Dominikmloy/fraction-collector/Collector_step/Führung lang v1.step

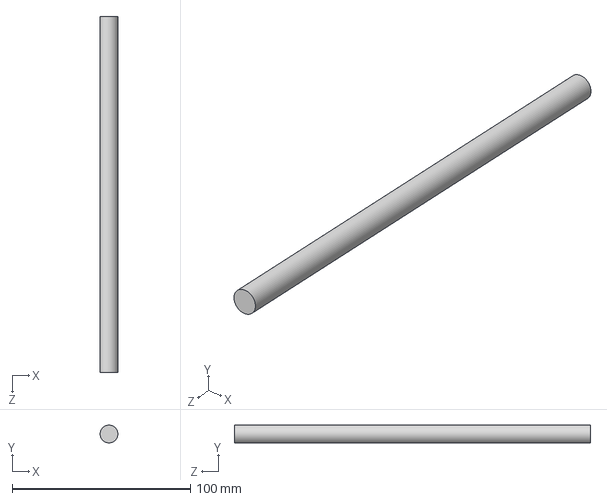
[picture p1: CAD file, 2020-12-05]
Collector_step/Führung lang v1.step
9.99 x 10.00 x 200.0 mm
