Dominikmloy/fraction-collector/Collector_step/Zahnscheibe T5 14-2  v1.step

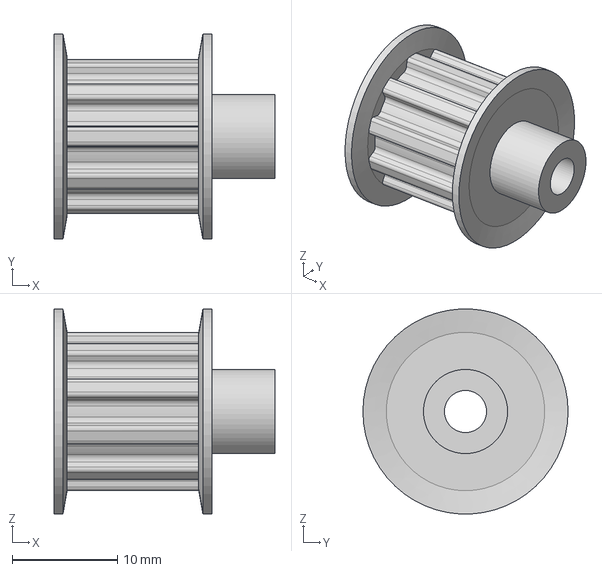
[picture p2: CAD file, 2020-12-05]
Collector_step/Zahnscheibe T5 14-2 v1.step
21.0 x 19.5 x 19.5 mm
