Dominikmloy/fraction-collector/Collector_step/Zahnscheibe T5 14-2 Sahlberg v1.step

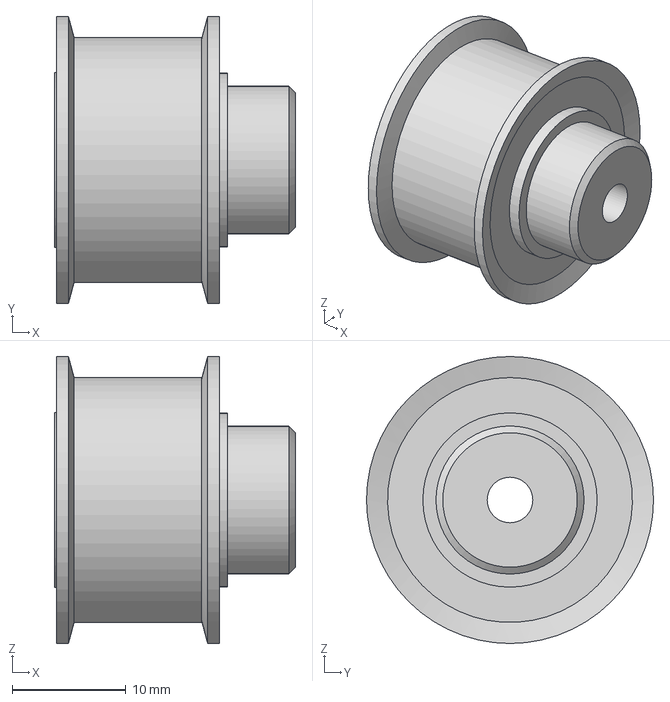
[picture p5: CAD file, 2020-12-05]
Collector_step/Zahnscheibe T5 14-2 Sahlberg v1.step
21.2 x 25.2 x 25.2 mm
