Dominikmloy/fraction-collector/Collector_step/Grundplatte v1.step

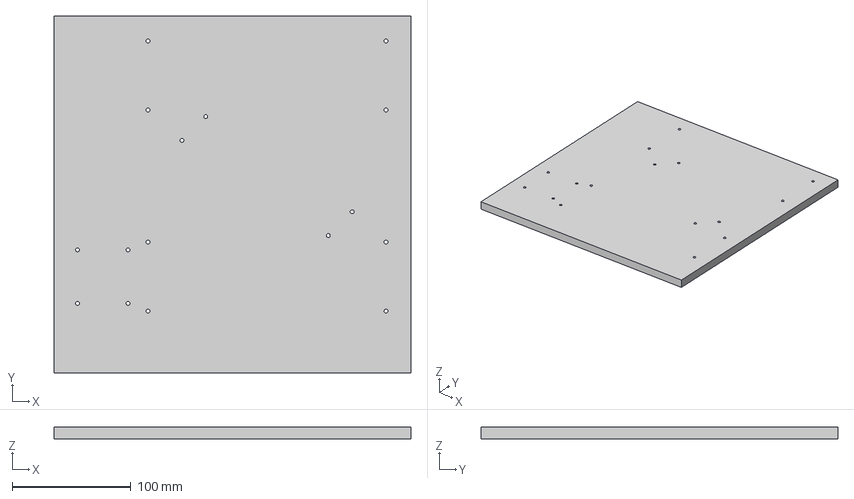
[picture p6: CAD file, 2020-12-05]
Collector_step/Grundplatte v1.step
300.0 x 300.0 x 10.0 mm
