Dominikmloy/fraction-collector/Collector_step/Klemmhalter Quersupport v1.step

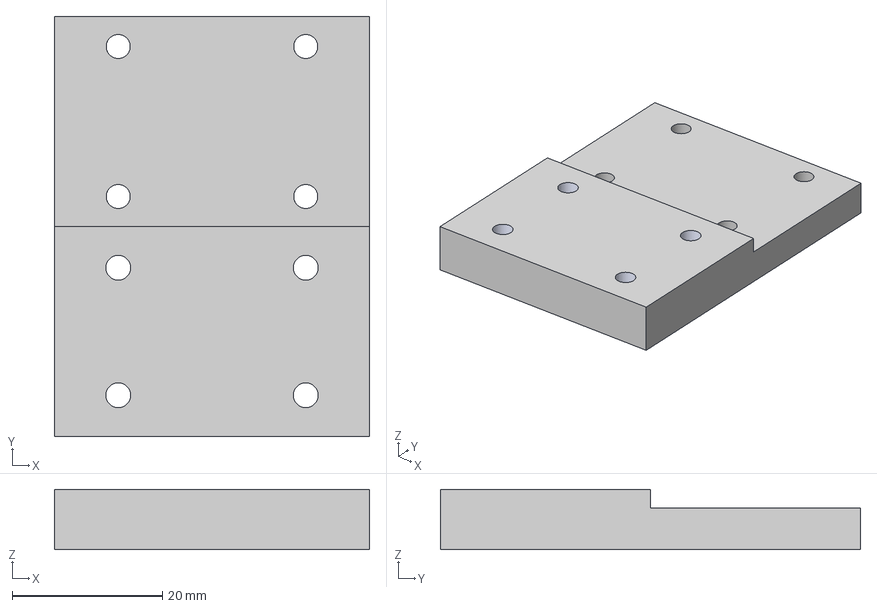
[picture p7: CAD file, 2020-12-05]
Collector_step/Klemmhalter Quersupport v1.step
42.0 x 56.0 x 8.00 mm
