Dominikmloy/fraction-collector/Collector_step/Führung kurz v1.step

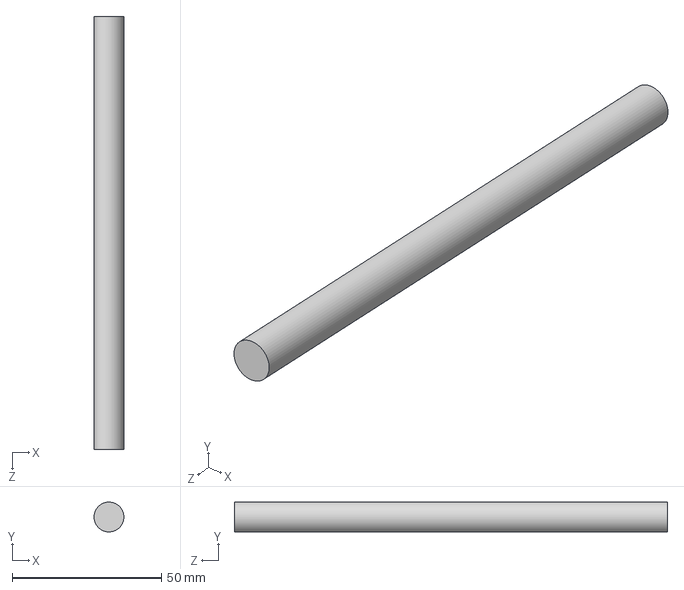
[picture p8: CAD file, 2020-12-05]
Collector_step/Führung kurz v1.step
9.99 x 10.00 x 145.0 mm
