Dominikmloy/fraction-collector/Collector_step/endschalterhalter v1.step

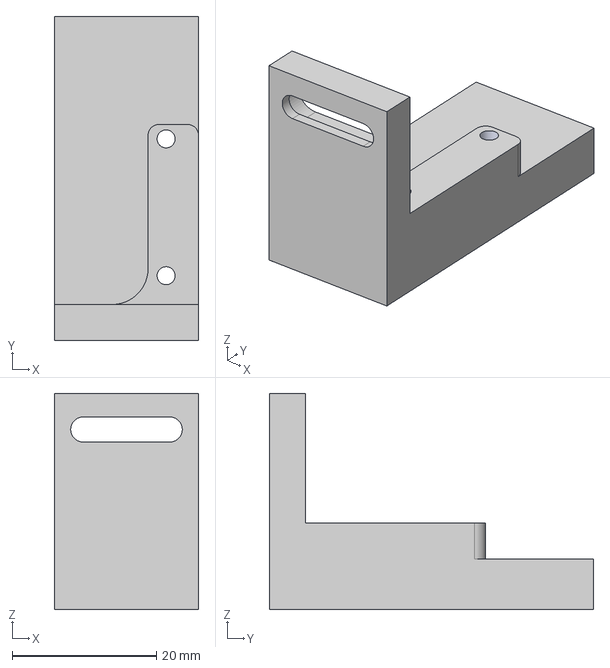
[picture p10: CAD file, 2020-12-05]
Collector_step/endschalterhalter v1.step
20.0 x 45.0 x 30.0 mm
