Dominikmloy/fraction-collector/Collector_step/Riehmen t5 9 v1.step

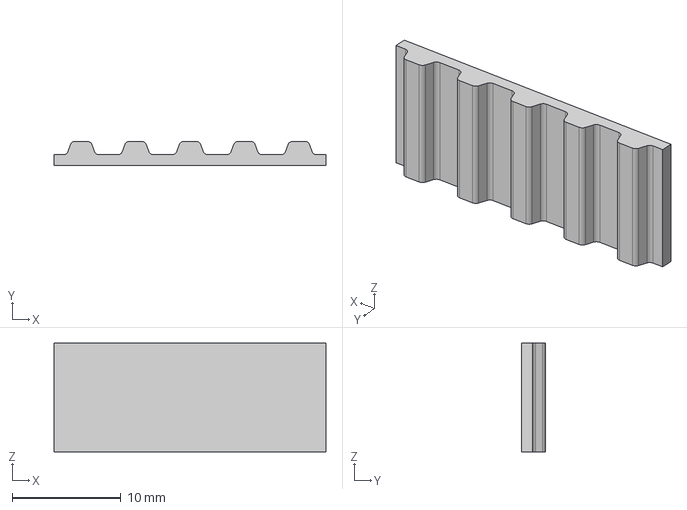
[picture p11: CAD file, 2020-12-05]
Collector_step/Riehmen t5 9 v1.step
25.0 x 2.20 x 10.0 mm
