Dominikmloy/fraction-collector/Collector_step/Motorhalterung2 v1.step

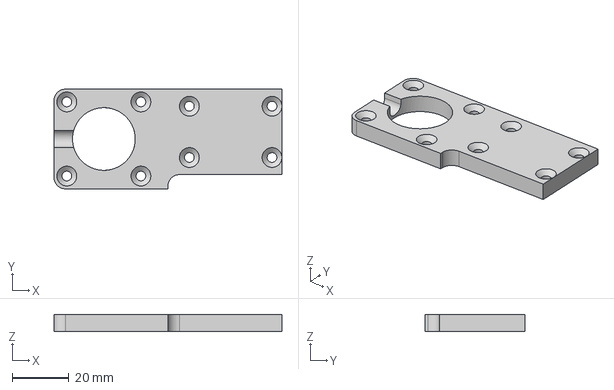
[picture p13: CAD file, 2020-12-05]
Collector_step/Motorhalterung2 v1.step
80.0 x 35.0 x 6.00 mm
