Dominikmloy/fraction-collector/Collector_step/Deckel v1.step

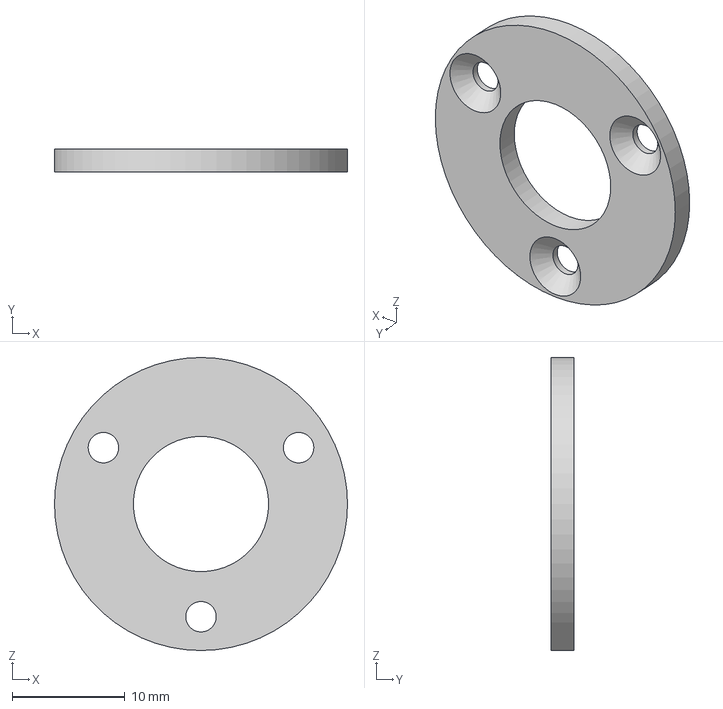
[picture p14: CAD file, 2020-12-05]
Collector_step/Deckel v1.step
26.0 x 2.00 x 26.0 mm
