Dominikmloy/fraction-collector/Collector_step/Motorhalterung v1.step

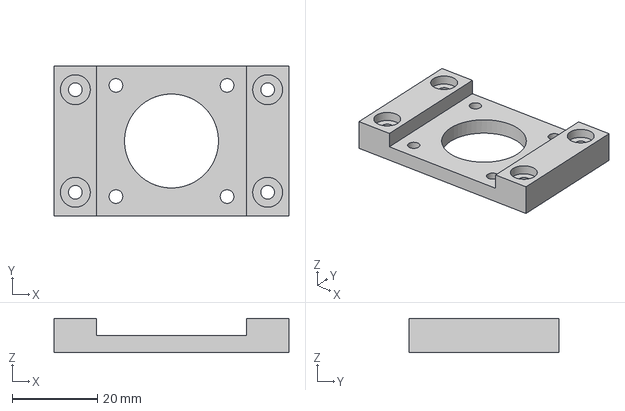
[picture p15: CAD file, 2020-12-05]
Collector_step/Motorhalterung v1.step
55.0 x 35.0 x 8.00 mm
