Dominikmloy/fraction-collector/Collector_step/Schrittmotor v1.step

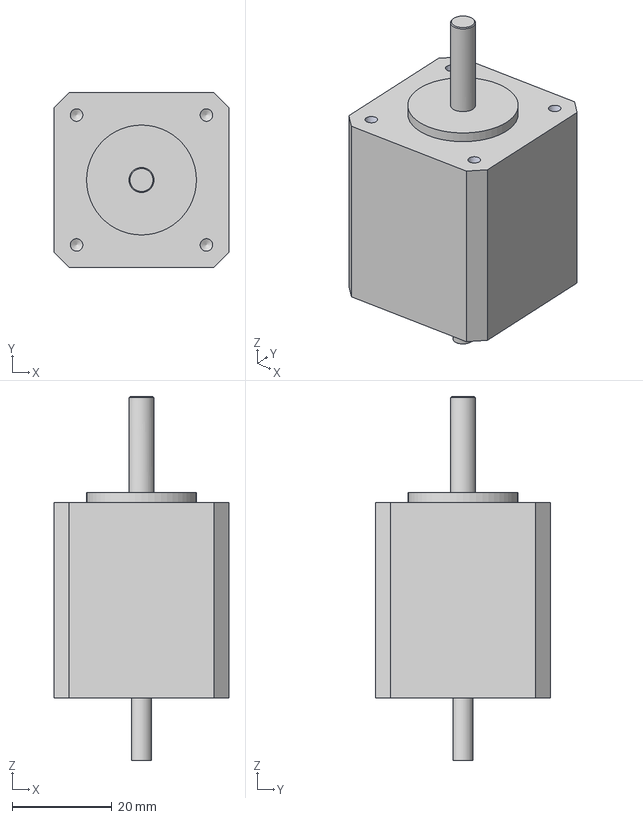
[picture p16: CAD file, 2020-12-05]
Collector_step/Schrittmotor v1.step
35.0 x 35.0 x 72.9 mm
