Dominikmloy/fraction-collector/Collector_step/Well platte v1.step

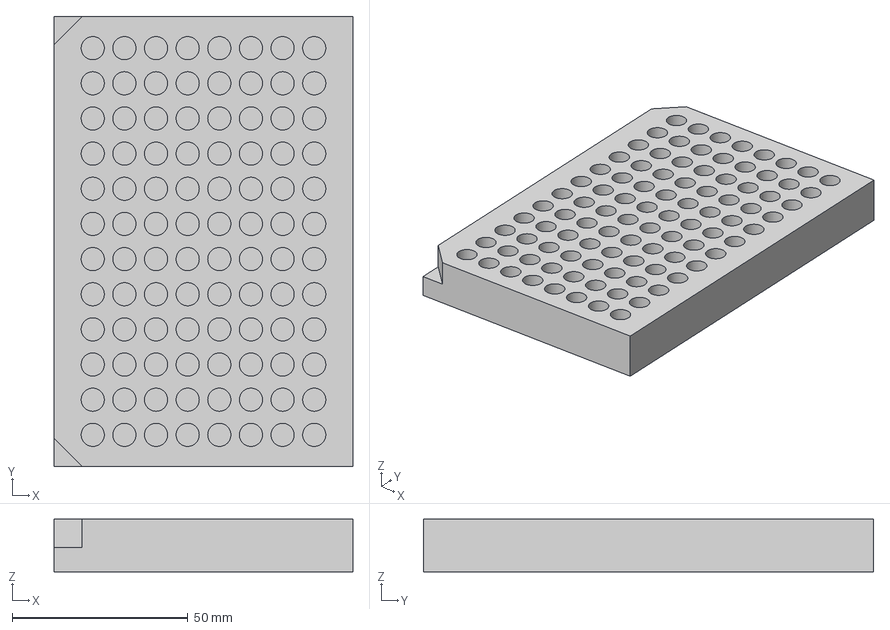
[picture p17: CAD file, 2020-12-05]
Collector_step/Well platte v1.step
85.0 x 128.0 x 15.0 mm
