Dominikmloy/fraction-collector/Collector_step/Klemmhalter schlitten v1.step

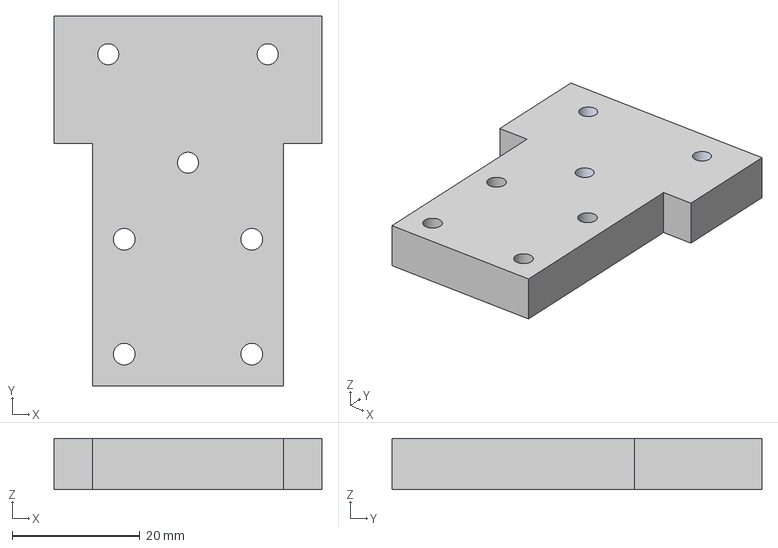
[picture p18: CAD file, 2020-12-05]
Collector_step/Klemmhalter schlitten v1.step
42.0 x 58.0 x 8.00 mm
