Dominikmloy/fraction-collector/Collector_step/Anschlag v1.step

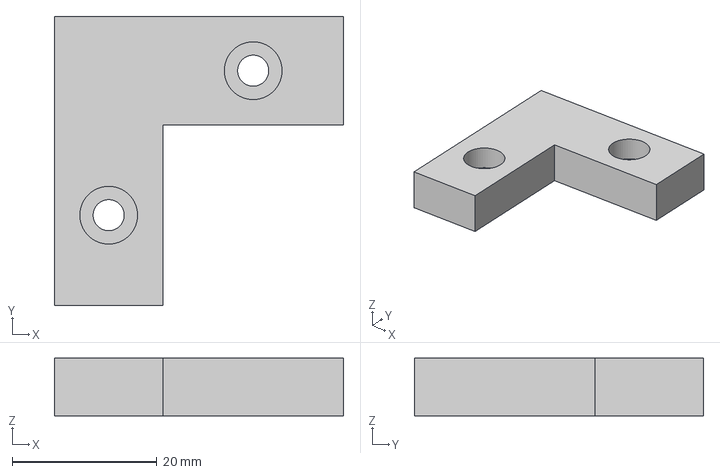
[picture p19: CAD file, 2020-12-05]
Collector_step/Anschlag v1.step
40.0 x 40.0 x 8.00 mm
