Dominikmloy/fraction-collector/Collector_step/Linearlager v1.step

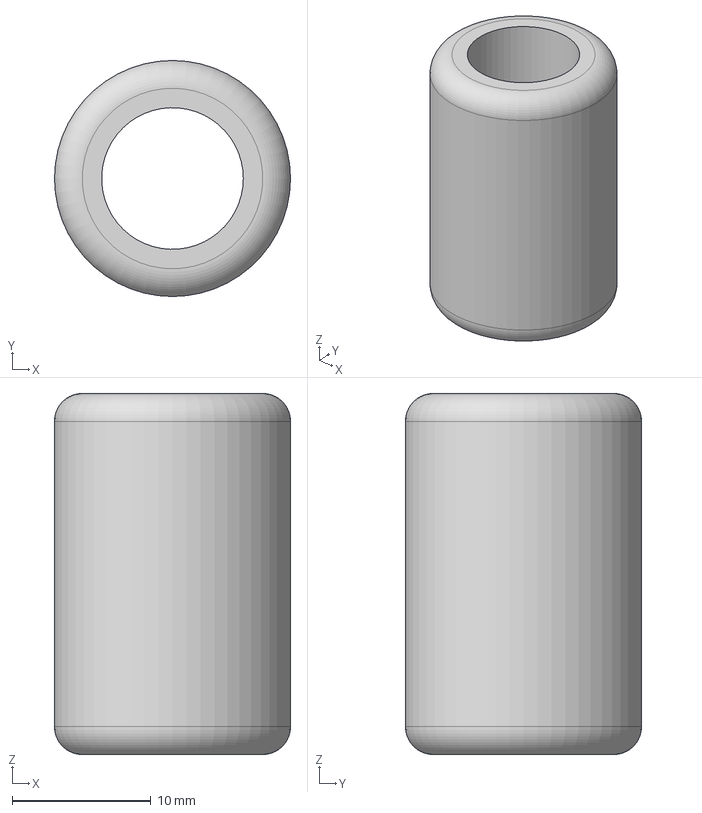
[picture p22: CAD file, 2020-12-05]
Collector_step/Linearlager v1.step
17.0 x 17.0 x 26.0 mm
