Dominikmloy/fraction-collector/(commit log)

2019-11-04 fixed several bugs in the code after running it with three syringe pumps.
2019-11-04 First usable initialization of the collector and one of the stop switches.
2019-11-05 Initialize.py: Moved and re-wrote some of the code from main.py in order to have a clean main.py with only the relevant functions for operating the fraction collector later on. Needs to be finished. 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
2019-11-06 Initialize.py: module is ready now. main.py: reaching starting position of stepper one accomplished.
2019-11-12 Restructured the program and wrote functions for setting it up and running it. Initialize.py: initializes the GPIO connections with RPi.GPIO and prints used pins to the screen. Sets up functions for 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
    [initialize.py, main.py, main_old.py, move.py, test.py]
2019-11-13 Finalized the program: Fixed some bugs. Importantly: initialize.py: removed lines for checking program execution and replaced them with a print command to display the current time in a readable forma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
    [initialize.py, main.py, move.py]
2020-02-14 added comments to increase readability od the code. inserted an argument into every function moving the steppers to set all pins to False (=no power) after each step.
2020-03-09 resetting the pins to False after every step does not work. Therefore, pins are resetted to 0 when function comes to an end.
    [move.py]
2020-04-25 *.step files of the fraction collector's parts
    [Anschlag v1.step, Bock1 v1.step, Deckel v1.step, Führung kurz v1.step, Führung lang v1.step, Grundplatte v1.step, Klemmhalter Quersupport v1.step, Klemmhalter schlitten v1.step]
